dbahles/STR_MON_TEST_JIG/docs/Daves notes.md

Now you’re entering the *real* firmware workflow phase 😊

What you want to avoid from here is:

* random AI-generated code blobs
* changing 5 things at once
* “just try this”
* losing working states
* architecture drift

The trick is:

# iterative controlled development

That’s how you stop the project becoming chaos.

---

# The Workflow I’d Recommend For You

## 1. Build in Layers

Do NOT jump around randomly.

Your development order should roughly be:

```text id="m1dr0t"
CORE FOUNDATION
    ↓
STATE MACHINE
    ↓
LOGGER
    ↓
LED SYSTEM
    ↓
COMMAND SYSTEM
    ↓
SIMULATION MODE
    ↓
TEST FRAMEWORK
    ↓
ADC MANAGER
    ↓
RELAY CONTROL
    ↓
REAL HARDWARE
    ↓
CALIBRATION
```

---

# 2. Only Change ONE System At A Time

Example:
❌ Add ADC + logger + relays + JSON together

Instead:
✅ Finish logger first
✅ Test logger
✅ Commit/save state
✅ Then move on

This is MASSIVE for embedded work.

---

# 3. Create “Known Good States”

This becomes your safety net.

Example:

```text id="v4lkg4"
v0.1  Boot + LEDs working
v0.2  Logger working
v0.3  State machine working
v0.4  Simulation tests working
```

If something breaks:

* you know EXACTLY where
* you can roll back mentally
* Codex has context

---

# 4. Use AI Like a Junior Engineer

This is VERY important.

Do NOT say:

```text id="6oyvnd"
Build the whole firmware
```

Instead:

```text id="7gbz3m"
Update only the logger module.
Do not modify any other files.
```

This prevents AI collateral damage.

---

# 5. Freeze Interfaces Early

This is professional firmware practice.

For example:

## Logger API

```cpp id="kjmb6q"
LogInfo(...)
LogError(...)
LogTest(...)
```

Once working:
❌ stop changing it constantly

Then the rest of firmware builds around stable interfaces.

---

# 6. Add Features Behind Flags

Example:

```cpp id="fh0x5s"
#define ENABLE_SIMULATION     true
#define ENABLE_JSON_LOGGING   false
#define ENABLE_ADC_FILTERING  false
```

This lets you:

* enable/disable systems safely
* isolate bugs
* test incrementally

---

# 7. Build a “Hardware Abstraction Layer”

This becomes VERY useful later.

Example:

```cpp id="5bm0ml"
GetPowerVoltage();
SetRelayOpenCircuit(true);
SetPassLED(true);
```

Then:

* simulation mode
* real hardware
* future hardware changes

all become easier.

---

# 8. MOST IMPORTANT:

# Make Tiny Testable Steps

Example good progression:

### Step 1

Blink Ready LED

### Step 2

Add logger

### Step 3

Print state changes

### Step 4

Add fake test

### Step 5

Trigger pass/fail LEDs

### Step 6

Add command parser

Each step:

* test
* validate
* save state
* move on

---

# 9. Start Using Git VERY Soon

Honestly…
NOW is probably the right time.

Not for “team development.”

For:

# safety

You will eventually:

* break things
* try experiments
* regret changes

Git saves embedded projects constantly.

---

# Your Simple Git Workflow

Inside VSCode terminal:

## Initial setup

```bash id="r7b9j3"
git init
```

## First save

```bash id="pc8d5n"
git add .
git commit -m "Initial firmware skeleton working"
```

Then after EACH stable milestone:

```bash id="kdhry1"
git add .
git commit -m "Added logger module"
```

This is honestly the single best anti-chaos tool you can adopt.

---

# 10. How To “Pick Up Where We Left Off”

This is the KEY part.

Each session:
give:

* current project state
* what works
* what doesn’t
* what changed recently
* what you want NEXT

Example:

```text id="37zl1m"
Current status:
- Logger working
- State machine working
- Simulation mode enabled
- LEDs operational

Next goal:
Add serial command parser without modifying existing logger system.
```

THAT gives AI stable context.

---

# 11. Create a DEVELOPMENT_NOTES.md

Inside `/docs`

Track:

* current state
* known issues
* next steps
* temporary hacks
* ideas

Example:

```markdown id="6gtv4g"
# Current Status

## Working
- Logger
- State machine
- LEDs

## TODO
- Serial command parser
- Simulation ADC

## Known Issues
- PASS LED timing rough
```

This becomes GOLD later.

---

# 12. My BIGGEST Recommendation For You

## Build The Simulator BEFORE Hardware

You’ll probably get:

* 60–70% of firmware done
* before PCB arrives

Then hardware integration becomes:
“connecting drivers”

instead of:
“inventing architecture under pressure.”

And that’s where embedded projects usually go sideways.
