dbahles/STR_MON_TEST_JIG/docs/STL FIles/Jig Adaptor.stl

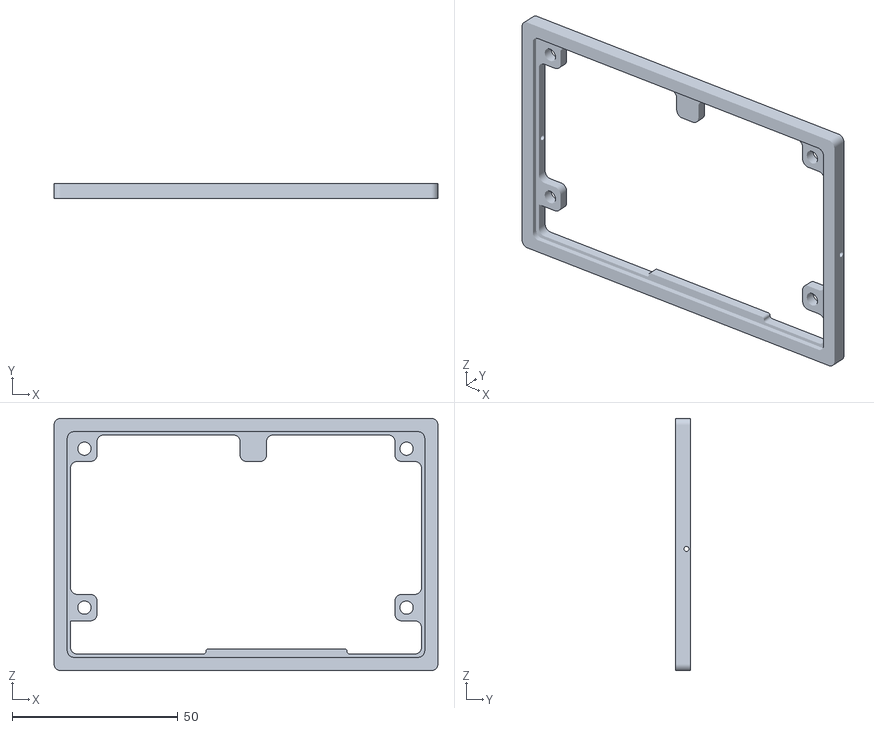
[picture p1: CAD file, 2026-06-09]
docs/STL FIles/Jig Adaptor.stl
116.0 x 4.60 x 76.1
