dbahles/STR_MON_TEST_JIG/docs/STL FIles/Jig Body.stl

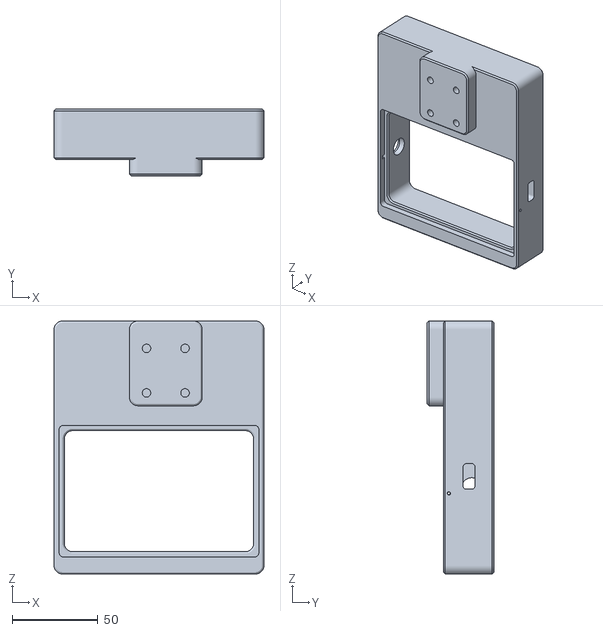
[picture p2: CAD file, 2026-06-09]
docs/STL FIles/Jig Body.stl
122.6 x 39.0 x 147.7
