dbahles/STR_MON_TEST_JIG/docs/STL FIles/DUT Adaptor.stl

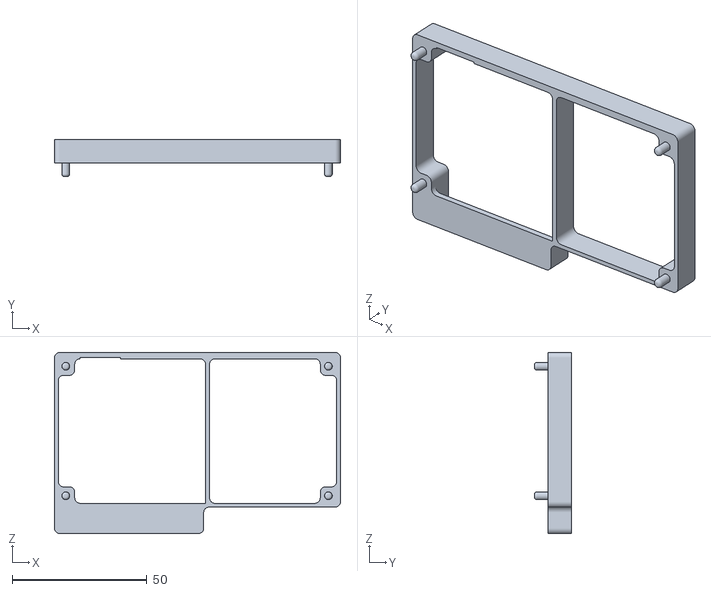
[picture p3: CAD file, 2026-06-09]
docs/STL FIles/DUT Adaptor.stl
106.0 x 13.8 x 67.1
