dbahles/STR_MON_TEST_JIG/include/serial_logger.h

#pragma once

#include <Arduino.h>
#include "system_state.h"
#include "test_defs.h"

namespace SerialLogger
{
    void begin(uint32_t baudRate);
    void printBootBanner();
    void info(const char *message);
    void error(const char *message);
    void stateChange(SystemState fromState, SystemState toState, const char *reason);
    void testStart(TestId testId);
    void testResult(TestId testId, TestResult result);
}
