dbahles/STR_MON_TEST_JIG/include/test_manager.h

#pragma once

#include <Arduino.h>

#include "test_defs.h"

class TestManager
{
public:
    void begin();
    TestResult runAllTests();
    TestResult runSingleTest(TestId testId);
    uint8_t getTestCount() const;
    TestId getTestId(uint8_t index) const;
    void printTestSequence();

private:
    TestResult runPowerTest();
    TestResult runAlarmPositiveTest();
    TestResult runAlarmNegativeTest();
    TestResult runOpenCircuitTest();
    TestResult runShortCircuitTest();
    TestResult runFaultRelayTest();
    TestResult runAlarmOutputTest(
        void (*setAlarmOutput)(bool),
        const char *activateMessage,
        const char *restoreMessage);
    TestResult runFaultSimulationTest(
        void (*setFaultOutput)(bool),
        const char *activateMessage,
        const char *restoreMessage);
};
