dbahles/STR_MON_TEST_JIG/src/calibration.cpp

#include "calibration.h"

namespace Calibration
{
    void begin()
    {
        // Future: load calibration values from non-volatile storage.
    }

    bool isValid()
    {
        return true;
    }
}
