dbahles/STR_MON_TEST_JIG/(commit log)

2026-05-27 Add open and short circuit tests
    [config.h, relay_control.cpp, relay_control.h, test_defs.cpp, test_defs.h, test_manager.cpp, test_manager.h]
2026-06-07 Alpha operator feedback and relay validation
